Printrbot/Adaptrboard/Simple Metal/readme.md

## Printrbot Simple Metal

Download Repo as zip for your board, This firmware is for BigTreeeTech SKR Mini e3 v1.2 

Copy the firmware.bin file to micro SD Card, insert into printer and power on. Wait 10 seconds, the red status light on the board will stop blinking when complete.
