Printrbot/Adaptrboard/Big Tree Tech TFT LCD Custom Firmware/readme.md

Customized TFT LCD firmware for Printrbot Copy these these files to root directory of SD card
