Printrbot/Adaptrboard/Play/readme.md

##Printrbot Play

Download Repo as zip for your board, Check the model of your board (v1.2 most common) copy the firmware.bin file to micro SD Card, insert into printer and power on. Wait 10 seconds, the red status light on the board will stop blinking when complete.

SKR Mini E3 V1.2
SKR Mini E3 V1.0
