Printrbot/Adaptrboard/Adaptrboard STL Files/Metal Plus/LRS-350 PSU/LRS-350 Case.JPG

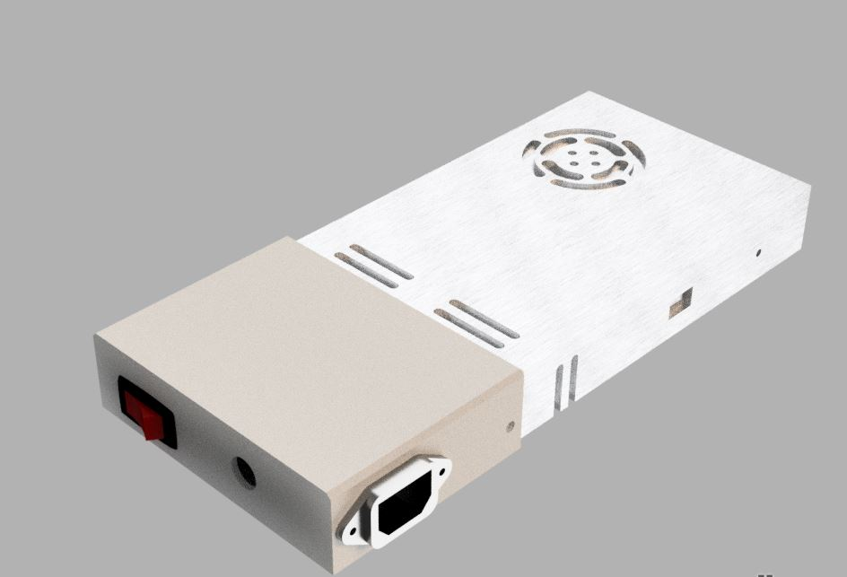
Adaptrboard STL Files/Metal Plus/LRS-350 PSU/LRS-350 Case.JPG
