Printrbot/Adaptrboard/Adaptrboard STL Files/Metal Plus/Metal Plus Adaptrboard.png

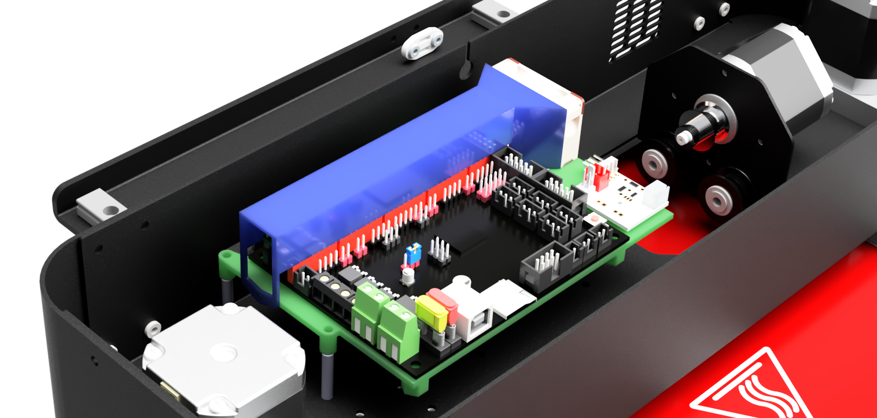
Adaptrboard STL Files/Metal Plus/Metal Plus Adaptrboard.png
