Printrbot/Adaptrboard/Adaptrboard STL Files/Simple Metal/Photos/board mount top.png

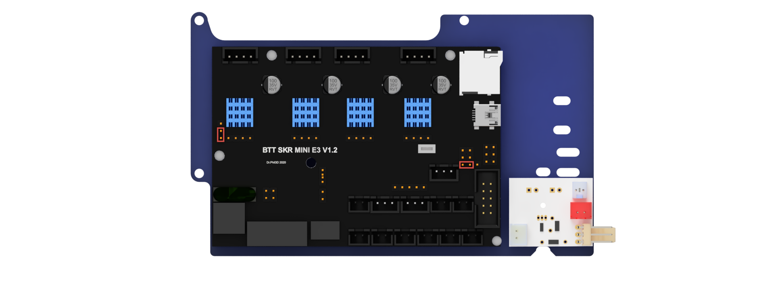
Adaptrboard STL Files/Simple Metal/Photos/board mount top.png
