Printrbot/Adaptrboard/Adaptrboard STL Files/Simple Metal/Photos/board mount.png

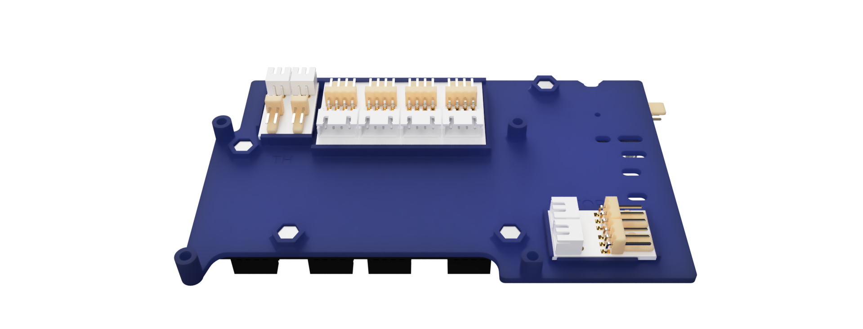
Adaptrboard STL Files/Simple Metal/Photos/board mount.png
