Printrbot/Adaptrboard/Adaptrboard STL Files/Simple Metal/Photos/simple metal upgraded.png

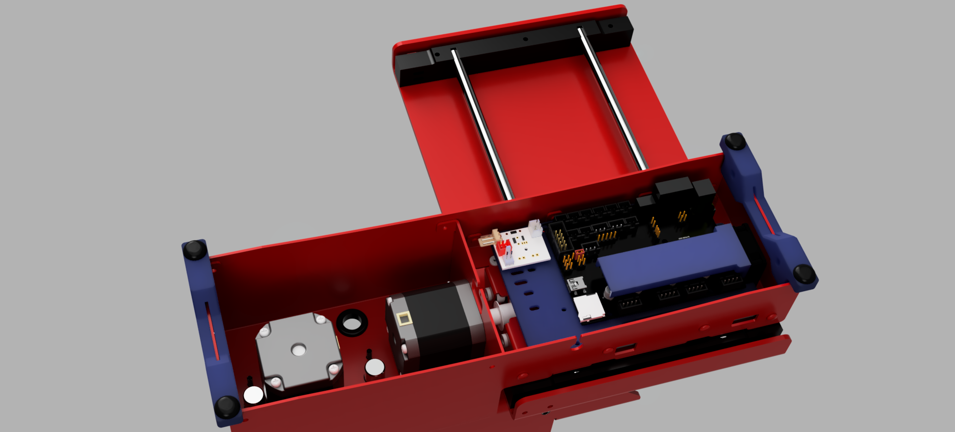
Adaptrboard STL Files/Simple Metal/Photos/simple metal upgraded.png
