Printrbot/Adaptrboard/Adaptrboard STL Files/Individual Cases/Thermistor Case.stl

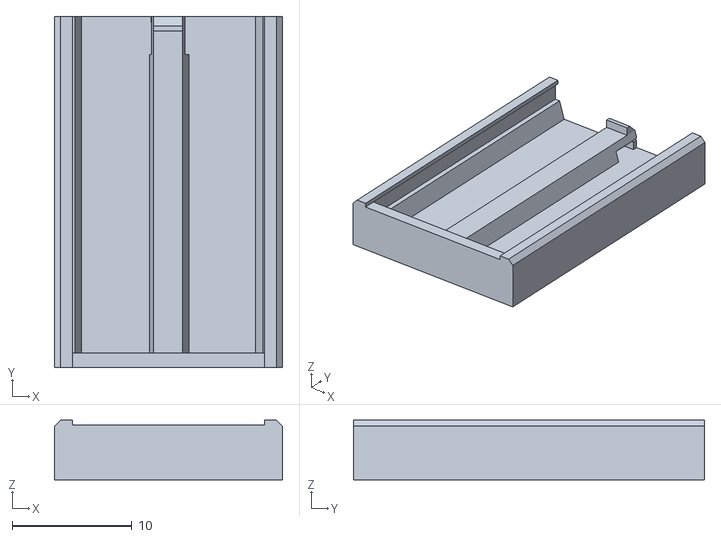
[picture p8: CAD file, 2020-04-28]
Adaptrboard STL Files/Individual Cases/Thermistor Case.stl
19.0 x 29.3 x 5.00
