Printrbot/Adaptrboard/Adaptrboard STL Files/Metal Plus/Metal Plus Adaptrboard_Stepper Fan Duct 40mmv1.stl

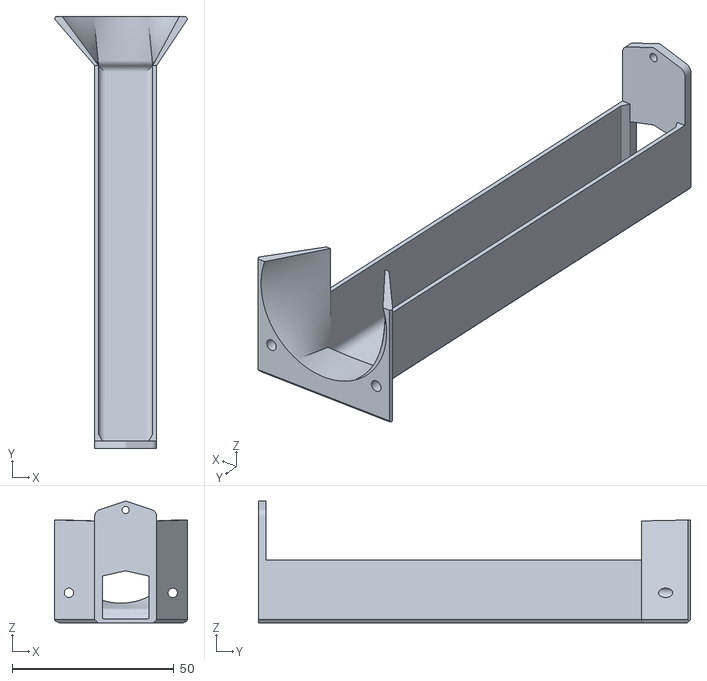
[picture p10: CAD file, 2020-05-24]
Adaptrboard STL Files/Metal Plus/Metal Plus Adaptrboard_Stepper Fan Duct 40mmv1.stl
41.2 x 133.7 x 37.7
