Printrbot/Adaptrboard/Printable Replacement Parts/Alu Extruder V2/Alu V2 Body.stl

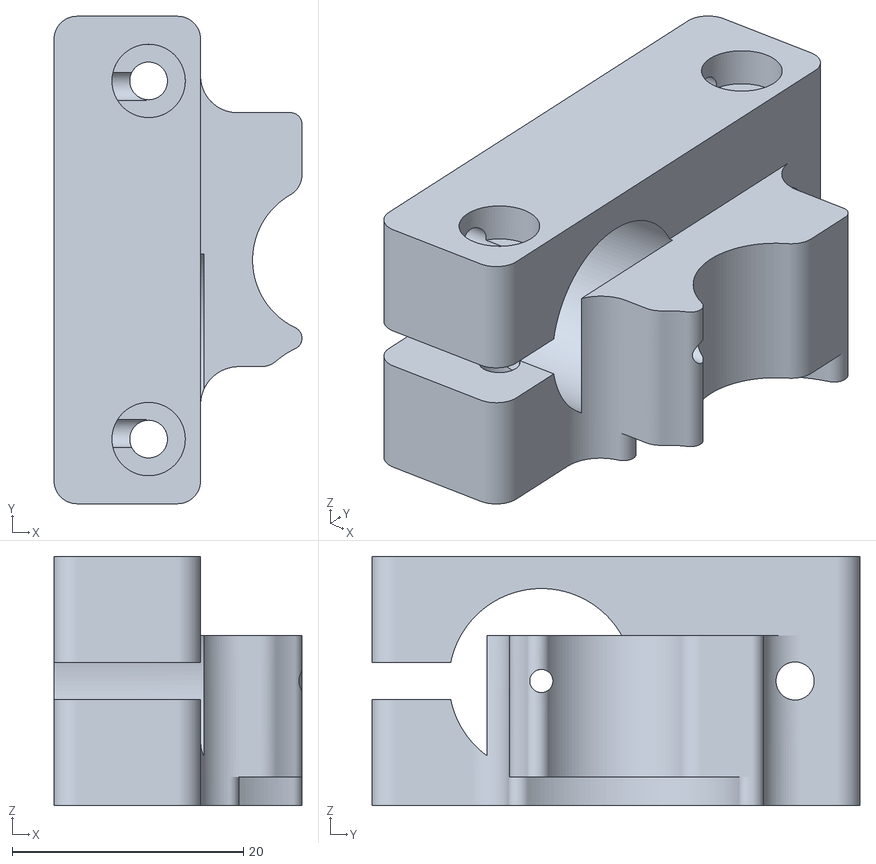
[picture p11: CAD file, 2020-05-17]
Printable Replacement Parts/Alu Extruder V2/Alu V2 Body.stl
21.5 x 42.2 x 21.6
