Printrbot/Adaptrboard/Printable Replacement Parts/Metal Plus/50 Fan Mount.stl

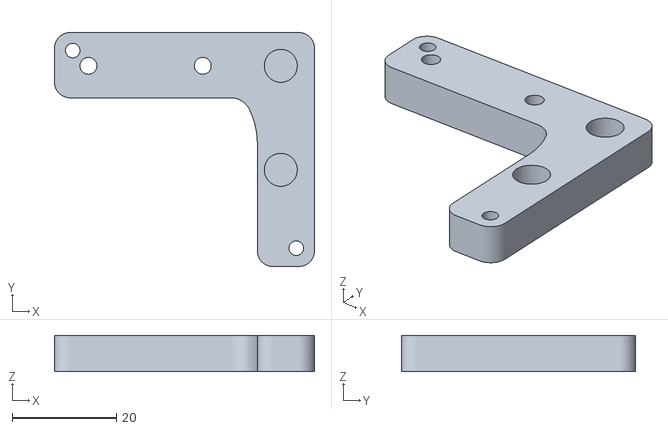
[picture p12: CAD file, 2020-05-12]
Printable Replacement Parts/Metal Plus/50 Fan Mount.stl
50.0 x 45.0 x 6.97
