Printrbot/Adaptrboard/Printable Replacement Parts/Metal Plus/Single Extruder Blower Fan/Plus_Blower_Fan_Mount_v2.stl

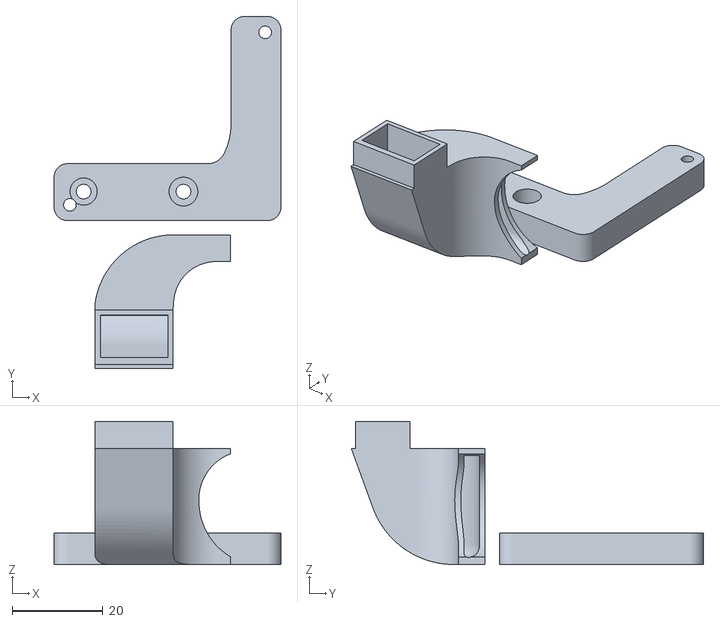
[picture p13: CAD file, 2020-05-24]
Printable Replacement Parts/Metal Plus/Single Extruder Blower Fan/Plus_Blower_Fan_Mount_v2.stl
50.0 x 77.6 x 31.5
