Printrbot/Adaptrboard/Printable Replacement Parts/Play V2 - Simple Pro/Playv2-SimplePro-Fan Shroud v4.stl

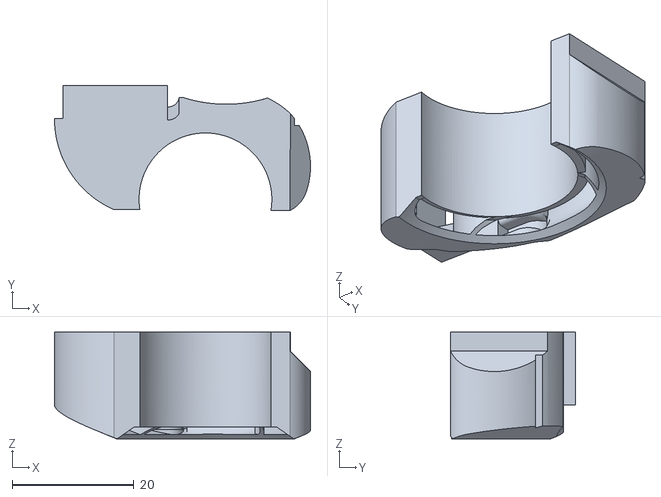
[picture p14: CAD file, 2020-05-17]
Printable Replacement Parts/Play V2 - Simple Pro/Playv2-SimplePro-Fan Shroud v4.stl
42.1 x 20.5 x 17.6
