Printrbot/Adaptrboard/Printable Replacement Parts/Play/4-Start Threaded Rod Upgrade/X-Z Spacer.stl

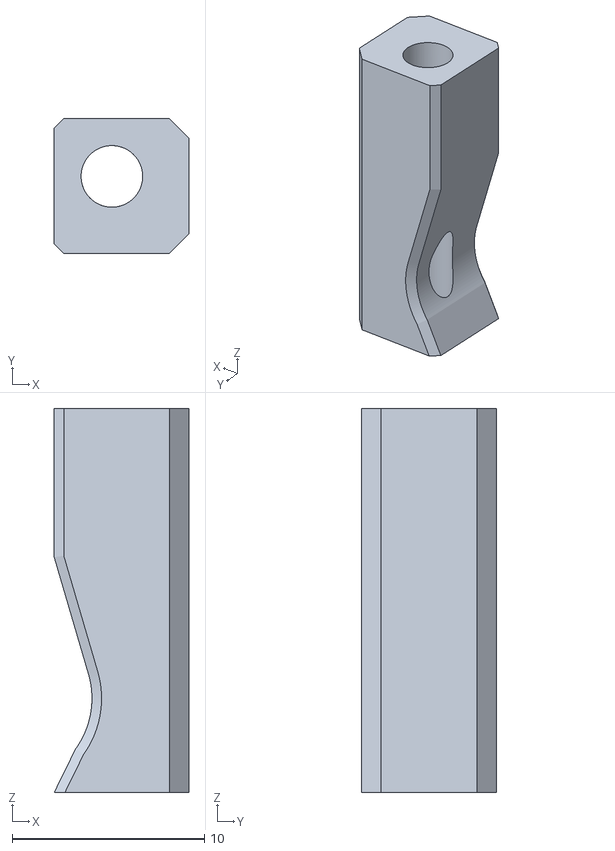
[picture p15: CAD file, 2020-05-12]
Printable Replacement Parts/Play/4-Start Threaded Rod Upgrade/X-Z Spacer.stl
7.00 x 7.00 x 20.0
