Printrbot/Adaptrboard/Printable Replacement Parts/Play/SKR-TFT LCD 2.4 Mount/TFT2.4 LCD.stl

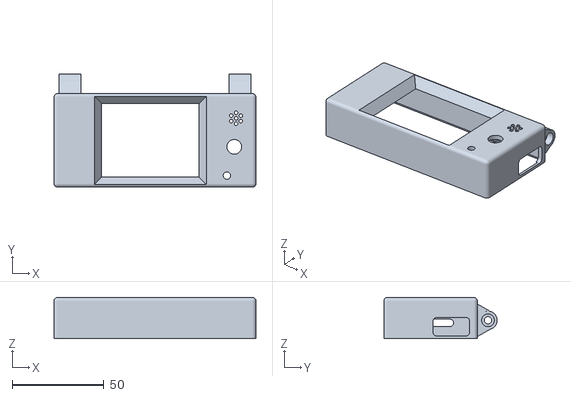
[picture p16: CAD file, 2020-05-12]
Printable Replacement Parts/Play/SKR-TFT LCD 2.4 Mount/TFT2.4 LCD.stl
110.0 x 61.8 x 22.5
