Printrbot/Adaptrboard/Printable Replacement Parts/Playv2-SimplePro-Fan Shroud v4 v3.stl

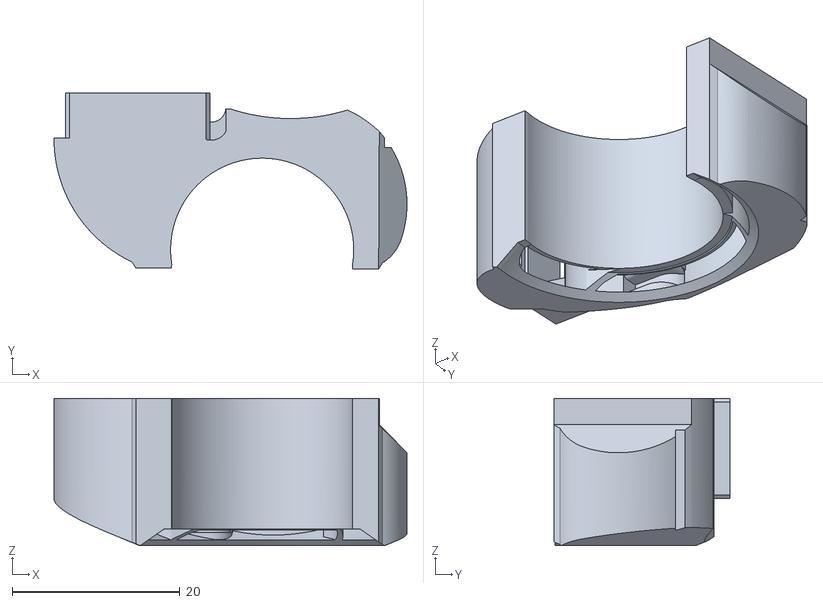
[picture p17: CAD file, 2020-05-24]
Printable Replacement Parts/Playv2-SimplePro-Fan Shroud v4 v3.stl
42.1 x 21.0 x 17.6
