Printrbot/Adaptrboard/Slicer Settings/Build Plate STL/Adoptabot X Axis Bed.stl

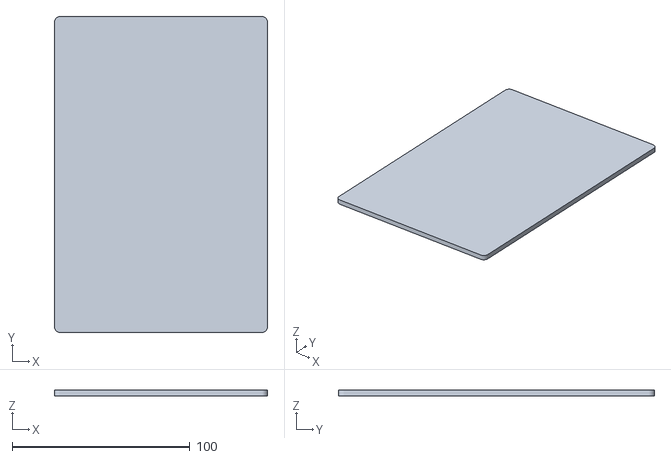
[picture p18: CAD file, 2020-04-26]
Slicer Settings/Build Plate STL/Adoptabot X Axis Bed.stl
120.0 x 178.0 x 3.18
