Printrbot/Adaptrboard/Adaptrboard STL Files/Individual Cases/Adaptrboard Case.stl

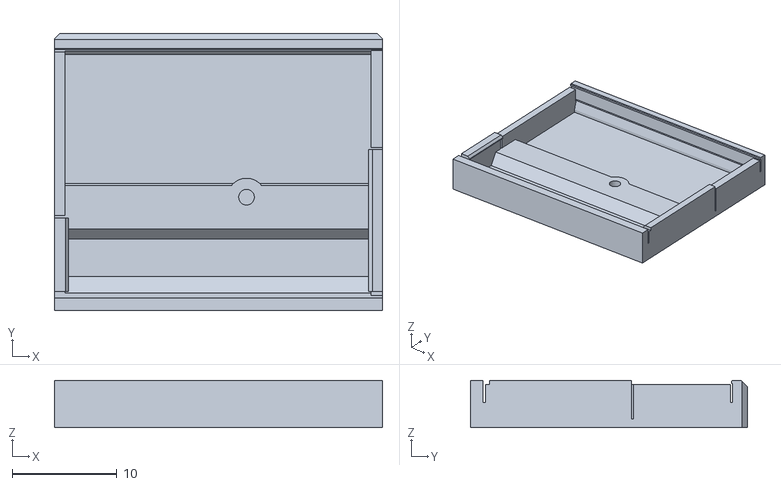
[picture p19: CAD file, 2020-04-28]
Adaptrboard STL Files/Individual Cases/Adaptrboard Case.stl
31.4 x 26.5 x 4.52
