Printrbot/Adaptrboard/Adaptrboard STL Files/Metal Plus/LRS-350 PSU/LRS-350-12 Case.stl

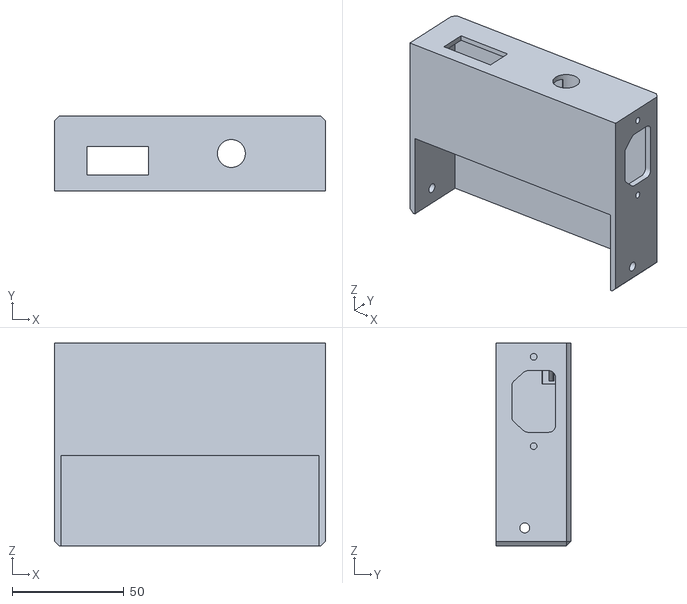
[picture p20: CAD file, 2020-05-25]
Adaptrboard STL Files/Metal Plus/LRS-350 PSU/LRS-350-12 Case.stl
121.4 x 33.4 x 90.8
