Printrbot/Adaptrboard/Adaptrboard STL Files/Metal Plus/Metal Plus Foot L.stl

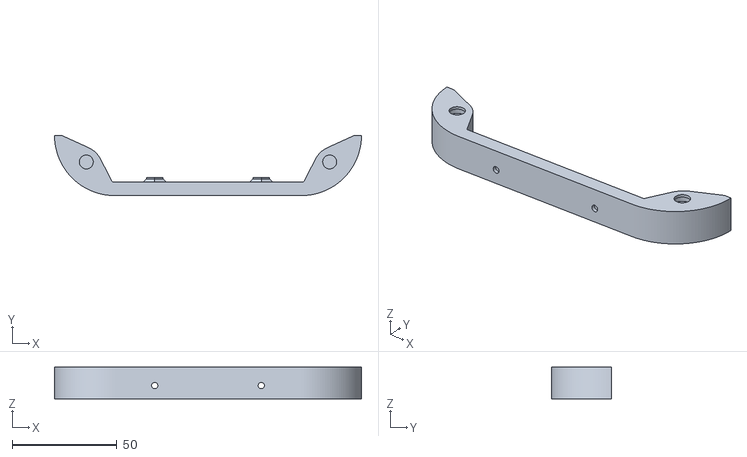
[picture p21: CAD file, 2020-05-24]
Adaptrboard STL Files/Metal Plus/Metal Plus Foot L.stl
146.3 x 28.7 x 15.2
