Printrbot/Adaptrboard/Printable Replacement Parts/Alu Extruder V2/Arm Post.stl

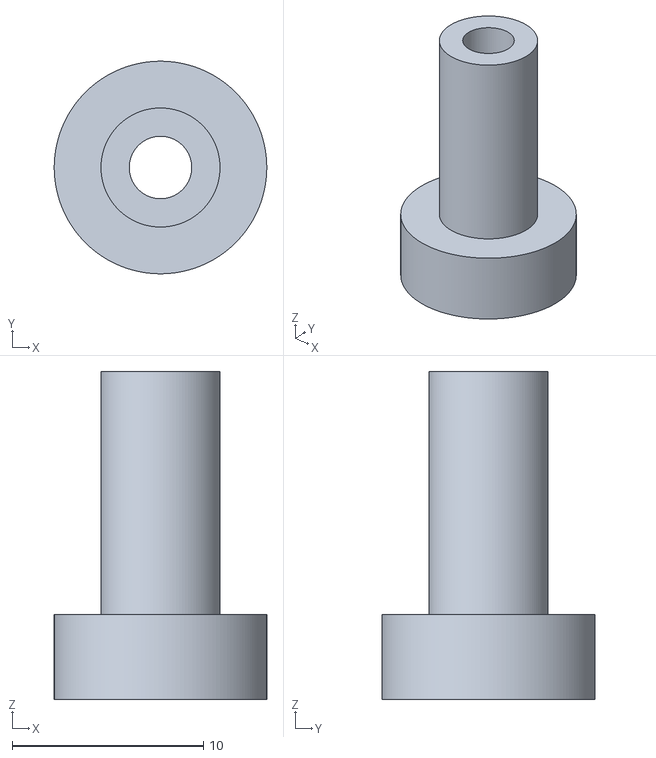
[picture p22: CAD file, 2020-05-17]
Printable Replacement Parts/Alu Extruder V2/Arm Post.stl
11.1 x 11.1 x 17.1
