Printrbot/Adaptrboard/Printable Replacement Parts/Metal Plus/Dual Extrusion Model/MP Sensor Mount v1.stl

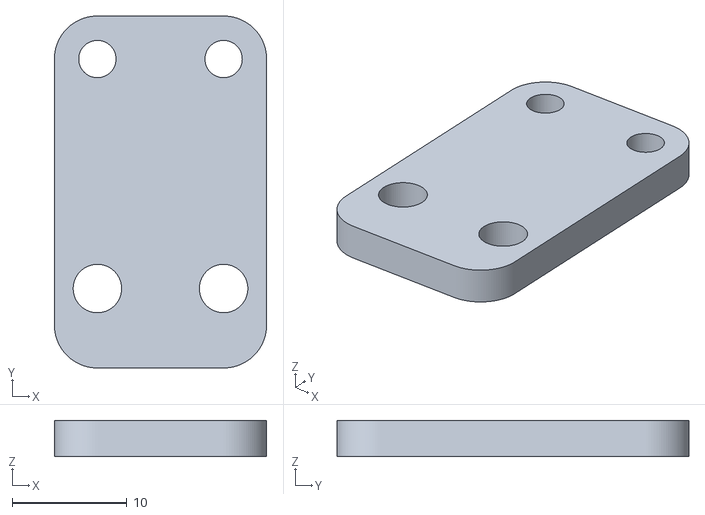
[picture p23: CAD file, 2020-05-12]
Printable Replacement Parts/Metal Plus/Dual Extrusion Model/MP Sensor Mount v1.stl
18.5 x 30.7 x 3.17
