Printrbot/Adaptrboard/Printable Replacement Parts/Metal Plus/Fan Mount.stl

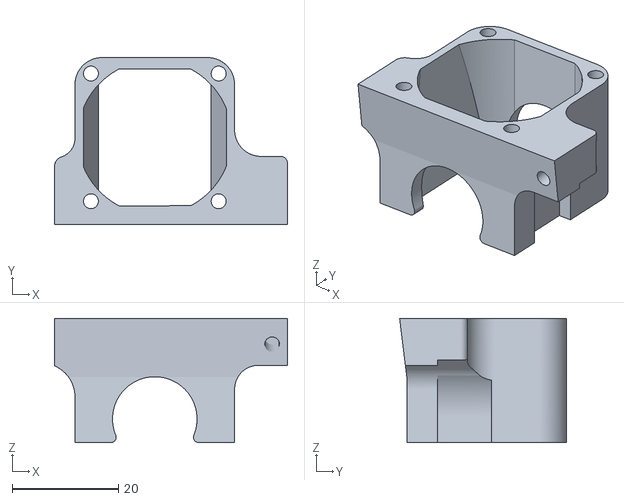
[picture p24: CAD file, 2020-05-12]
Printable Replacement Parts/Metal Plus/Fan Mount.stl
43.8 x 31.3 x 23.4
