Printrbot/Adaptrboard/Printable Replacement Parts/Play/Inductive Probe Clamp.stl

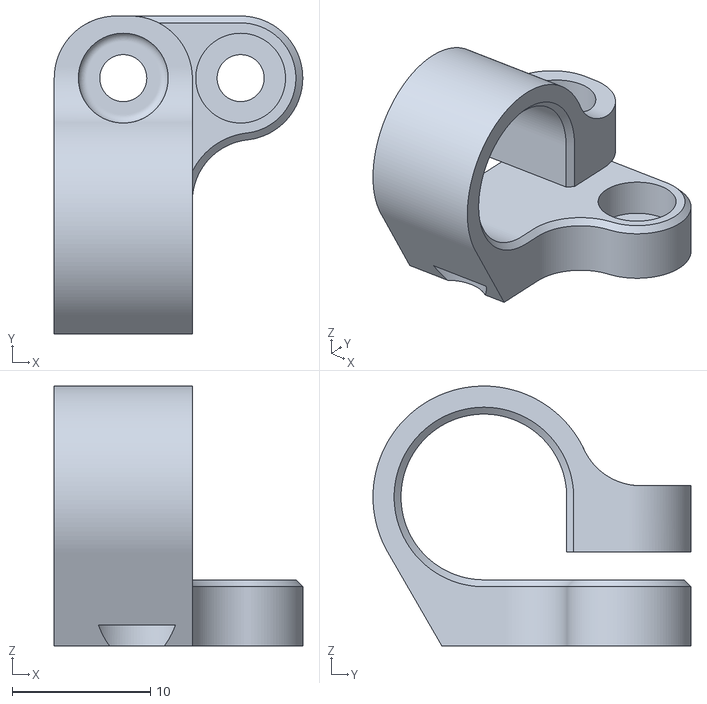
[picture p25: CAD file, 2020-05-12]
Printable Replacement Parts/Play/Inductive Probe Clamp.stl
18.0 x 23.0 x 18.8
