Printrbot/Adaptrboard/Printable Replacement Parts/Play/SKR-TFT LCD 2.4 Mount/TFT2.4 LCD Mount.stl

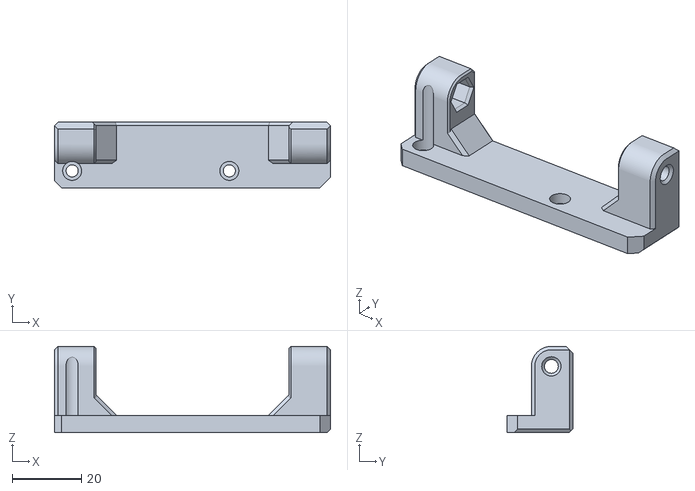
[picture p26: CAD file, 2020-05-12]
Printable Replacement Parts/Play/SKR-TFT LCD 2.4 Mount/TFT2.4 LCD Mount.stl
80.0 x 19.0 x 25.0
