Printrbot/Adaptrboard/Printable Replacement Parts/Printable Idler Pulley.stl

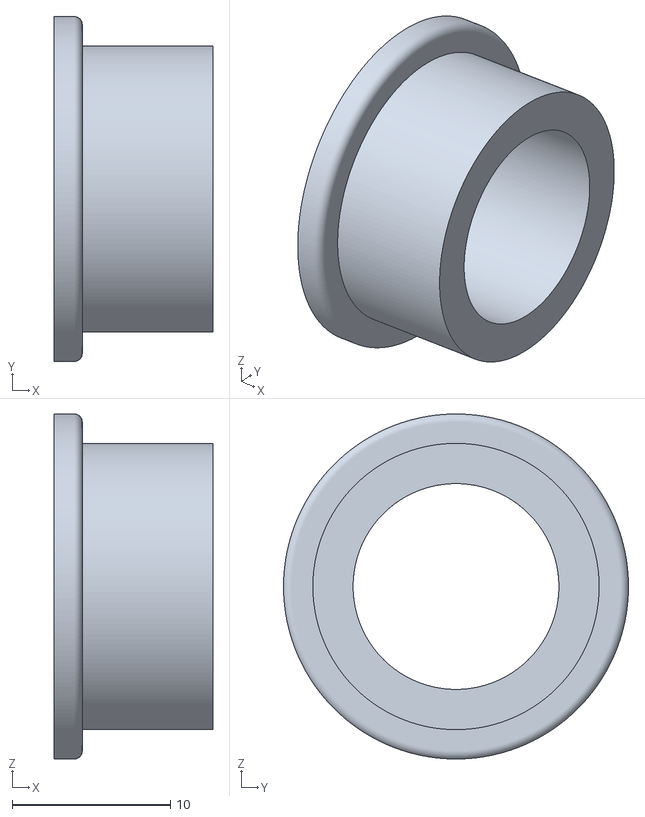
[picture p27: CAD file, 2020-05-12]
Printable Replacement Parts/Printable Idler Pulley.stl
10.0 x 21.8 x 21.8
