Printrbot/Adaptrboard/Slicer Settings/Build Plate STL/Simple Metal 10x8in bed.stl

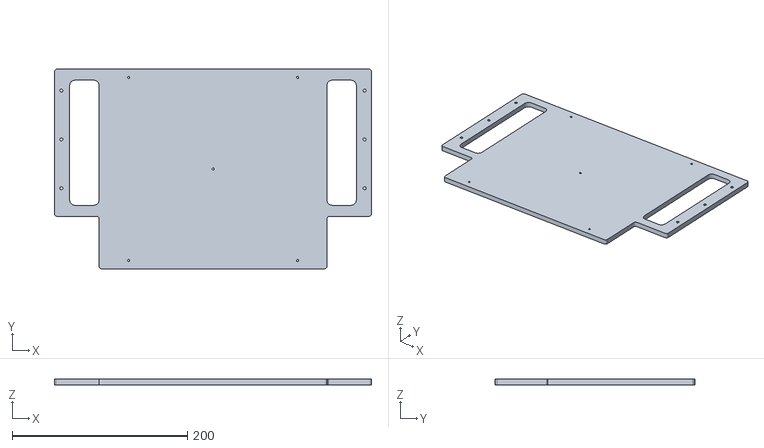
[picture p28: CAD file, 2020-04-26]
Slicer Settings/Build Plate STL/Simple Metal 10x8in bed.stl
362.1 x 228.3 x 6.35
