Printrbot/Adaptrboard/Adaptrboard STL Files/Individual Cases/Motor Breakout Case.stl

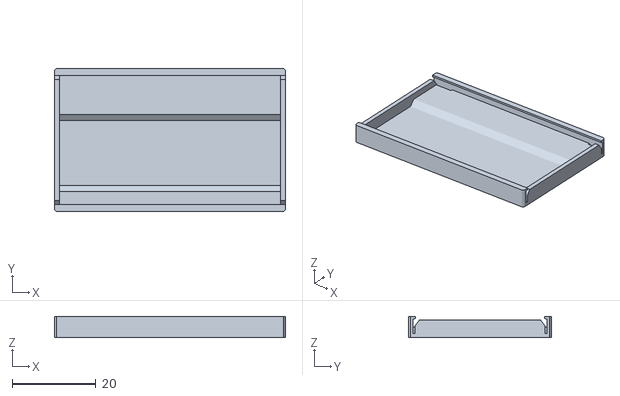
[picture p29: CAD file, 2020-04-28]
Adaptrboard STL Files/Individual Cases/Motor Breakout Case.stl
55.3 x 34.3 x 5.03
