Printrbot/Adaptrboard/Adaptrboard STL Files/Metal Plus/Metal Plus Foot R.stl

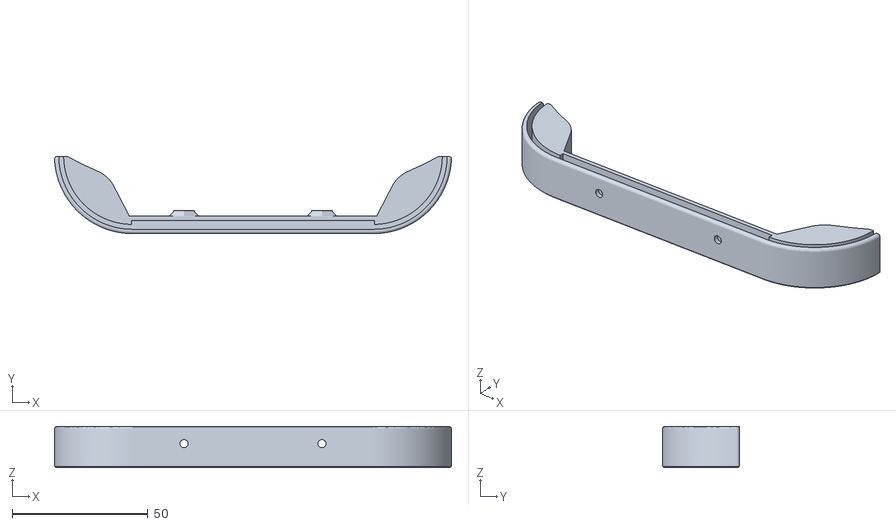
[picture p30: CAD file, 2020-05-24]
Adaptrboard STL Files/Metal Plus/Metal Plus Foot R.stl
146.2 x 28.5 x 15.2
