Printrbot/Adaptrboard/Adaptrboard STL Files/Simple Metal/Simple Metal - Front and Rear Feet.stl

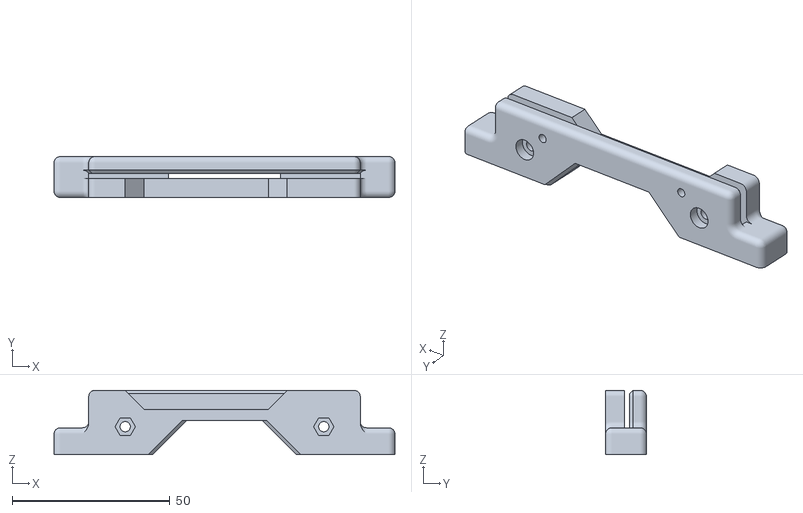
[picture p31: CAD file, 2020-05-11]
Adaptrboard STL Files/Simple Metal/Simple Metal - Front and Rear Feet.stl
108.1 x 13.0 x 20.4
