Printrbot/Adaptrboard/Printable Replacement Parts/Alu Extruder V2/Alu V2 Arm.stl

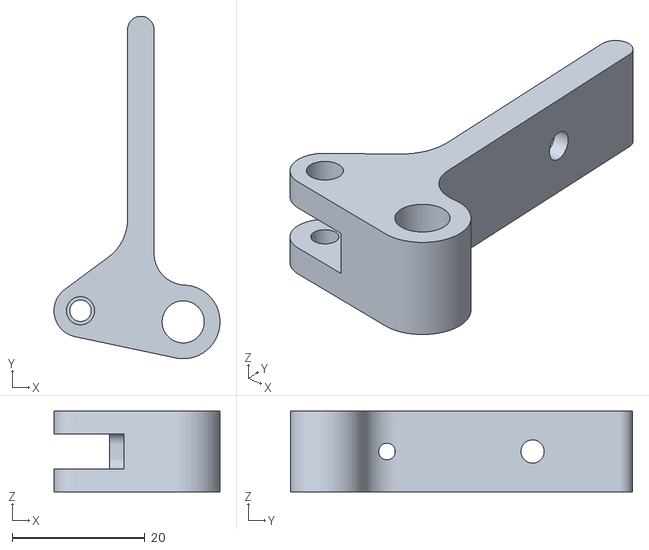
[picture p32: CAD file, 2020-05-17]
Printable Replacement Parts/Alu Extruder V2/Alu V2 Arm.stl
25.1 x 51.7 x 12.2
