Printrbot/Adaptrboard/Printable Replacement Parts/Metal Plus/Dual Extrusion Model/Fan Blower v2 Left.stl

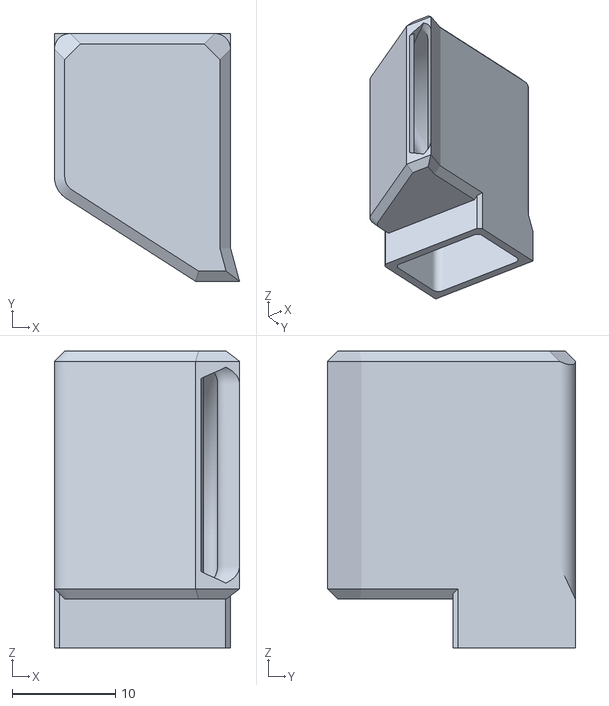
[picture p33: CAD file, 2020-05-12]
Printable Replacement Parts/Metal Plus/Dual Extrusion Model/Fan Blower v2 Left.stl
18.0 x 24.1 x 28.8
