Printrbot/Adaptrboard/Printable Replacement Parts/Metal Plus/Single Extruder Blower Fan/Plus Blower Fan Shroud.3mf

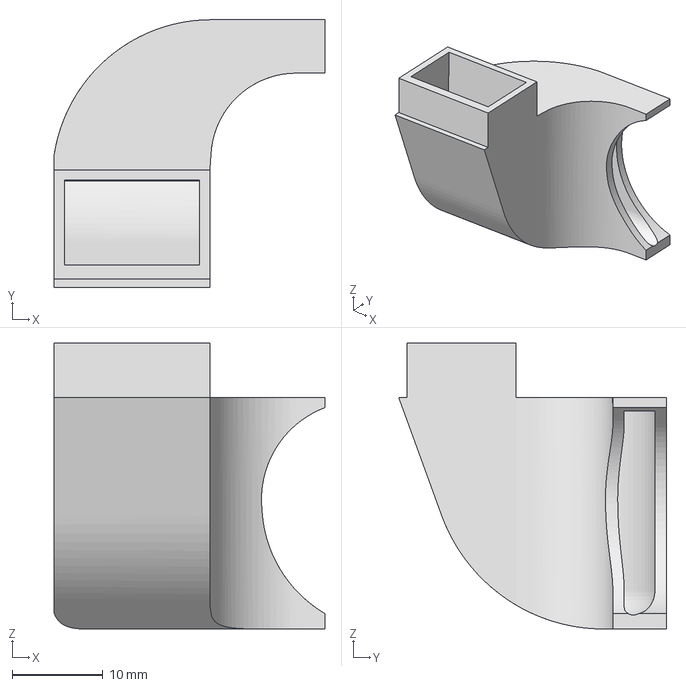
[picture p34: CAD file, 2020-05-24]
Printable Replacement Parts/Metal Plus/Single Extruder Blower Fan/Plus Blower Fan Shroud.3mf
29.8 x 29.5 x 31.5 mm
