Printrbot/Adaptrboard/Printable Replacement Parts/Play/Y-Bearing Holder Single.stl

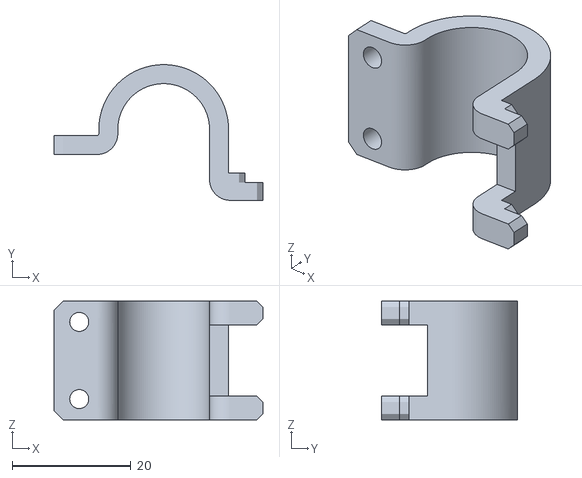
[picture p35: CAD file, 2020-05-12]
Printable Replacement Parts/Play/Y-Bearing Holder Single.stl
35.2 x 22.9 x 20.0
