Printrbot/Adaptrboard/Slicer Settings/Build Plate STL/Play Heated Bed Model 100mmx205mm.stl

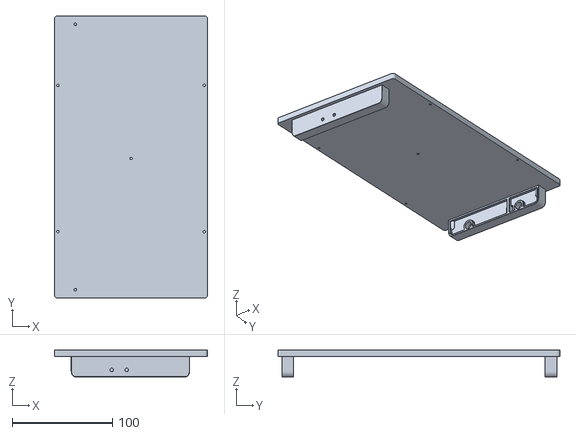
[picture p36: CAD file, 2020-04-26]
Slicer Settings/Build Plate STL/Play Heated Bed Model 100mmx205mm.stl
152.9 x 281.4 x 26.7
