Printrbot/Adaptrboard/Adaptrboard STL Files/Simple Metal/Simple Metal - Adaptrboard - Controler Fan Duct.stl

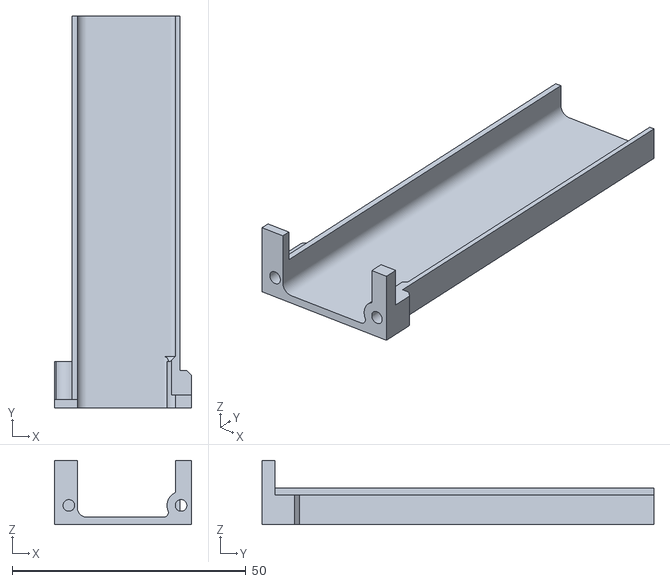
[picture p37: CAD file, 2020-05-11]
Adaptrboard STL Files/Simple Metal/Simple Metal - Adaptrboard - Controler Fan Duct.stl
29.3 x 83.9 x 13.7
