Printrbot/Adaptrboard/Printable Replacement Parts/Play/PB Mini Y Bar End Tensioner Side.stl

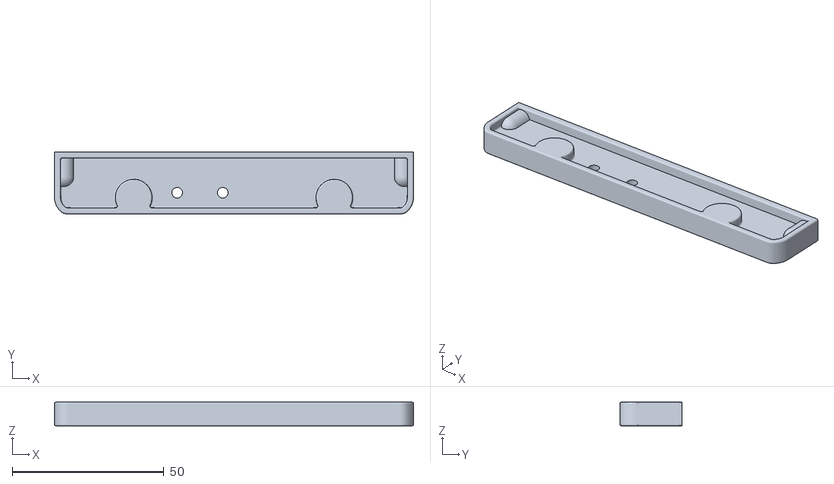
[picture p38: CAD file, 2020-05-12]
Printable Replacement Parts/Play/PB Mini Y Bar End Tensioner Side.stl
118.1 x 20.4 x 7.87
