Printrbot/Adaptrboard/Slicer Settings/Build Plate STL/Simple Pro Print Bed.stl

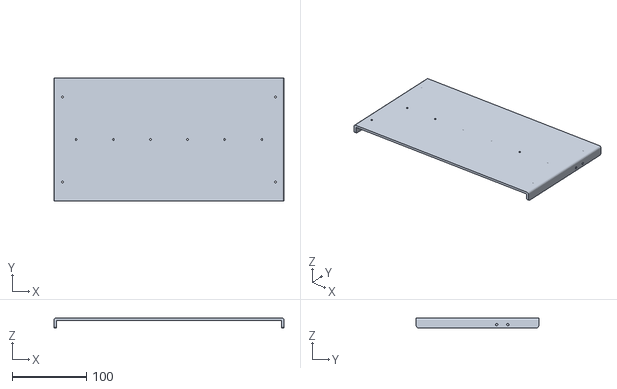
[picture p39: CAD file, 2020-04-26]
Slicer Settings/Build Plate STL/Simple Pro Print Bed.stl
309.8 x 165.1 x 13.5
