Printrbot/Adaptrboard/Adaptrboard STL Files/Metal Plus/Spacer.stl

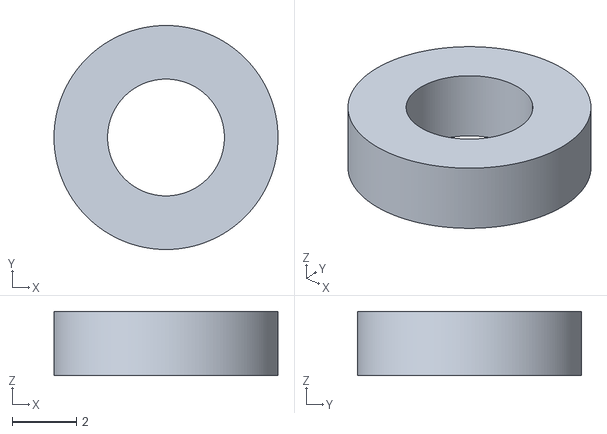
[picture p40: CAD file, 2020-05-11]
Adaptrboard STL Files/Metal Plus/Spacer.stl
7.00 x 7.00 x 2.00
