Printrbot/Adaptrboard/Printable Replacement Parts/Metal Plus/Dual Extrusion Model/Single Fan Dual Hotend.stl

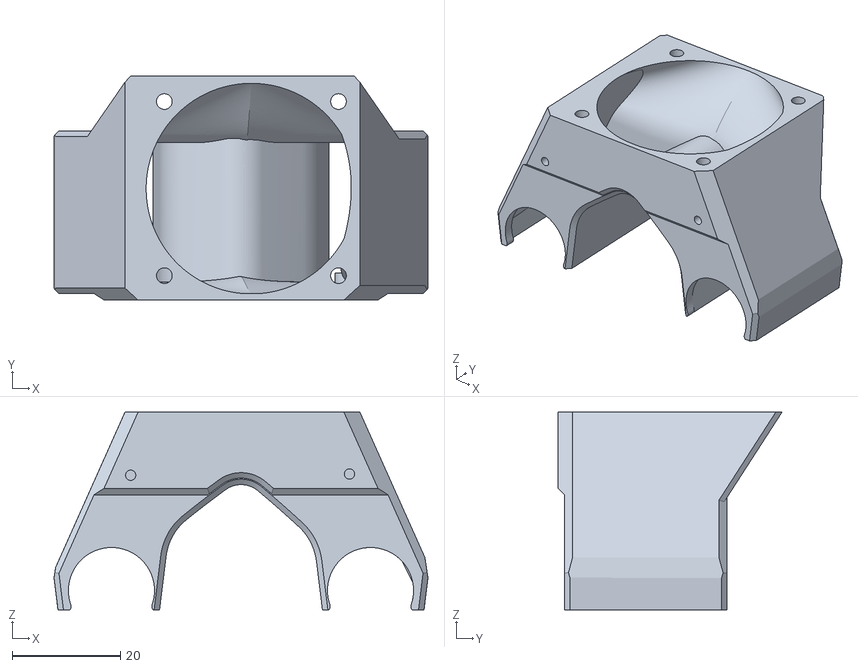
[picture p41: CAD file, 2020-05-12]
Printable Replacement Parts/Metal Plus/Dual Extrusion Model/Single Fan Dual Hotend.stl
69.0 x 41.3 x 36.5
