Printrbot/Adaptrboard/Printable Replacement Parts/Play/50mm Fan Mount.stl

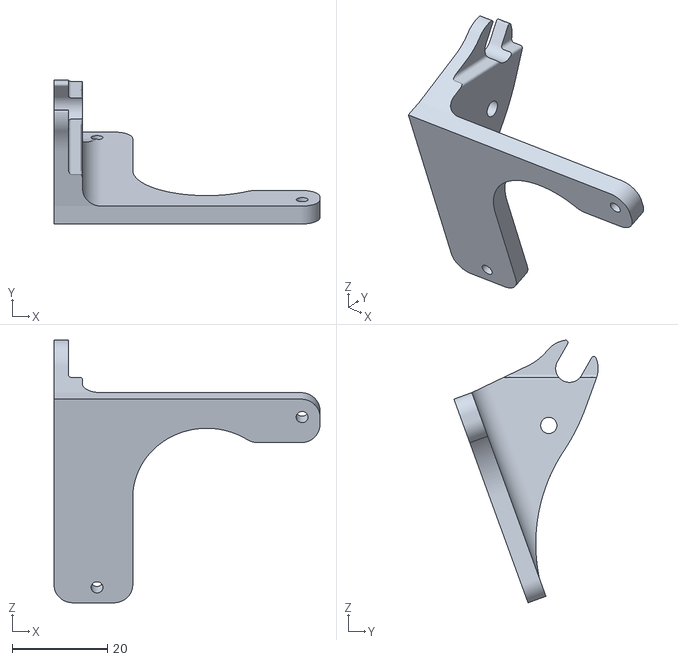
[picture p42: CAD file, 2020-05-12]
Printable Replacement Parts/Play/50mm Fan Mount.stl
55.8 x 30.2 x 55.1
