Printrbot/Adaptrboard/Slicer Settings/Build Plate STL/Simple Metal 10in bed.stl

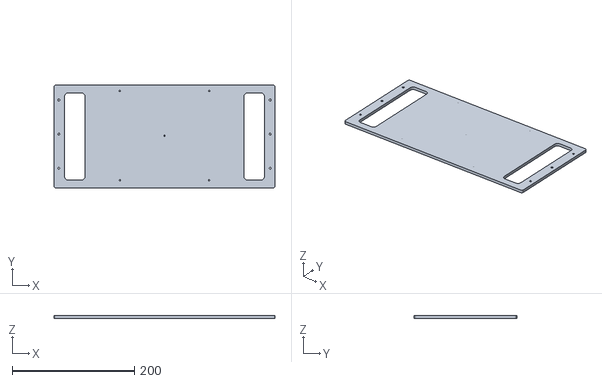
[picture p43: CAD file, 2020-04-26]
Slicer Settings/Build Plate STL/Simple Metal 10in bed.stl
362.1 x 168.3 x 4.76
