Printrbot/Adaptrboard/Adaptrboard STL Files/Metal Plus/Metal Plus Adaptrboard_Board Mount v1.stl

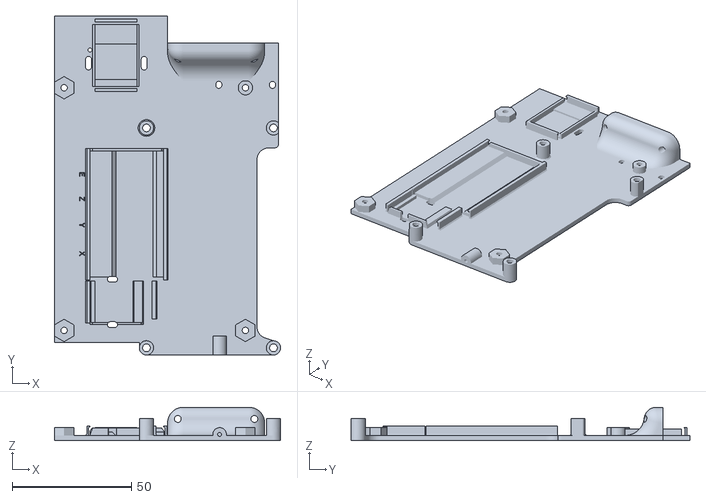
[picture p44: CAD file, 2020-05-11]
Adaptrboard STL Files/Metal Plus/Metal Plus Adaptrboard_Board Mount v1.stl
94.9 x 142.3 x 13.9
