Printrbot/Adaptrboard/Printable Replacement Parts/Play/Printrbot Play - Dual Bering Y Axis Clamp.stl

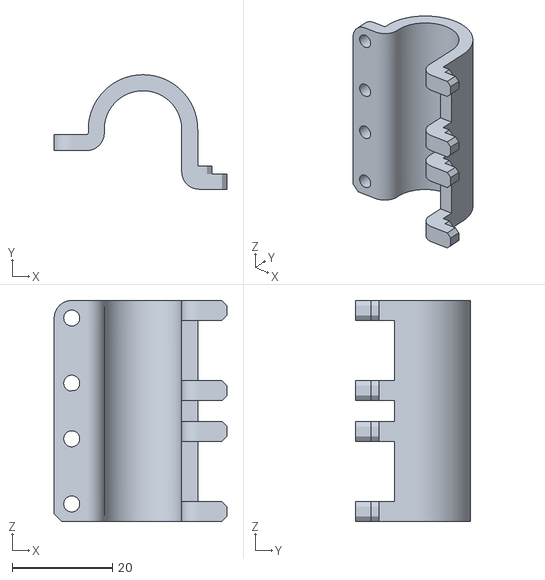
[picture p45: CAD file, 2020-05-12]
Printable Replacement Parts/Play/Printrbot Play - Dual Bering Y Axis Clamp.stl
34.4 x 22.9 x 44.1
