Printrbot/Adaptrboard/Slicer Settings/Build Plate STL/Simple Metal Stock Bed.stl

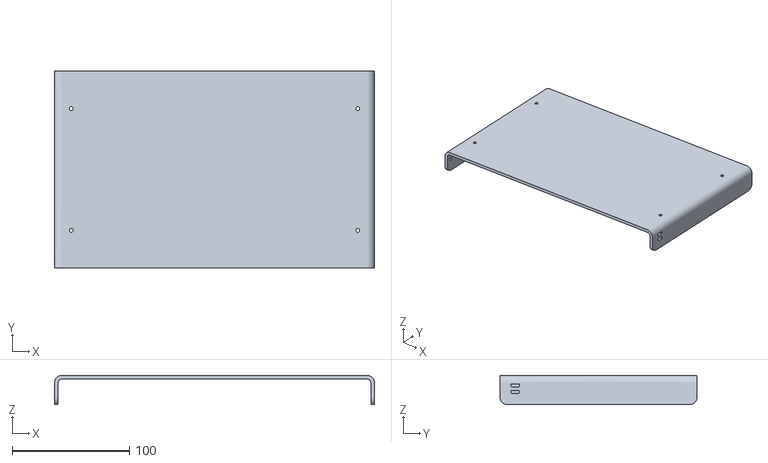
[picture p46: CAD file, 2020-04-26]
Slicer Settings/Build Plate STL/Simple Metal Stock Bed.stl
273.4 x 168.3 x 25.0
