Printrbot/Adaptrboard/Printable Replacement Parts/Play/Turbo Fan 50mm Fan Duct.stl

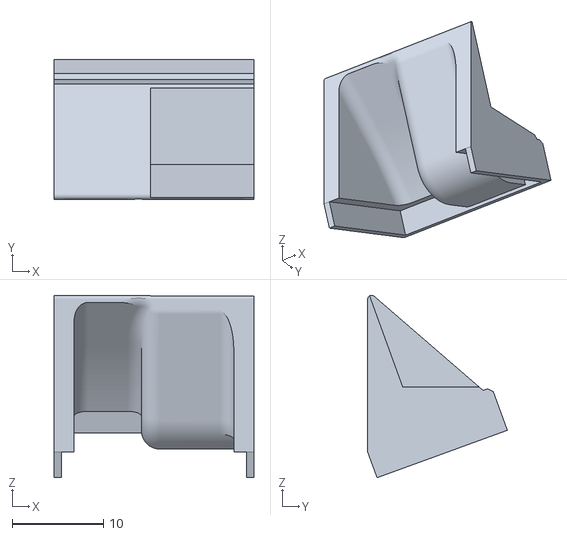
[picture p47: CAD file, 2020-05-12]
Printable Replacement Parts/Play/Turbo Fan 50mm Fan Duct.stl
21.9 x 15.3 x 19.9
