Printrbot/Adaptrboard/Slicer Settings/Build Plate STL/Printrbot Plus Bed - Alu Only.stl

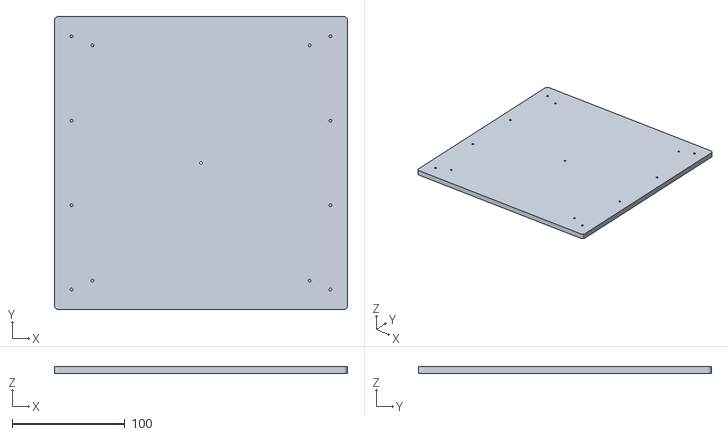
[picture p48: CAD file, 2020-04-26]
Slicer Settings/Build Plate STL/Printrbot Plus Bed - Alu Only.stl
260.4 x 260.4 x 6.35
