Printrbot/Adaptrboard/Printable Replacement Parts/Play/Delrin Cable tab from back of extruder.dxf

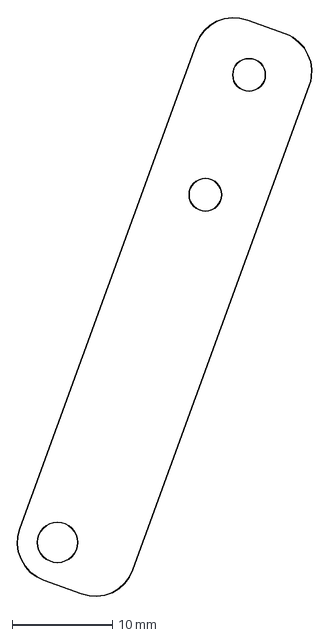
[picture p49: CAD file, 2020-05-12]
Printable Replacement Parts/Play/Delrin Cable tab from back of extruder.dxf
29.9 x 57.8 mm
