Printrbot/Adaptrboard/Slicer Settings/Build Plate STL/Printrbot Smalls Bed.stl

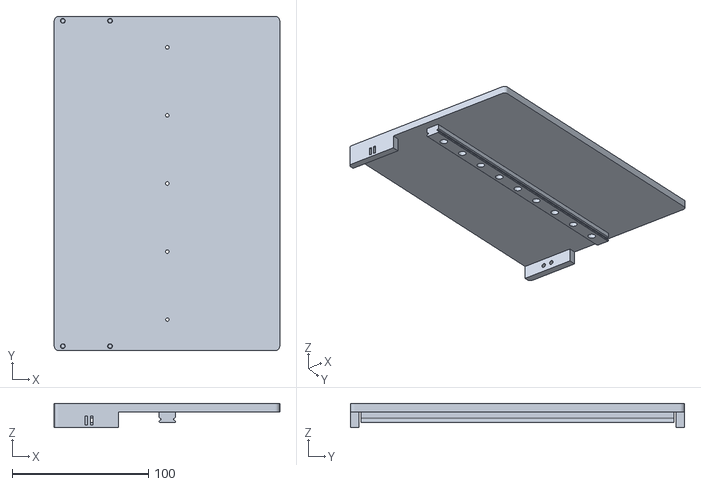
[picture p50: CAD file, 2020-04-26]
Slicer Settings/Build Plate STL/Printrbot Smalls Bed.stl
165.7 x 245.4 x 17.8
