Printrbot/Adaptrboard/(list of files, cad)

Other CAD files:
Printable Replacement Parts/Metal Plus/Dual Extrusion Model/Plus 50mm Blower Fan_Mount_v2.3mf
Printable Replacement Parts/Metal Plus/Single Extruder Blower Fan/Plus 50mm Blower Fan_Mount_v2.3mf
Adaptrboard STL Files/Metal Plus/Metal Plus Feet.stl
Printable Replacement Parts/Metal Plus/Dual Extrusion Model/Fan Blower v2 Right.stl
Adaptrboard STL Files/Metal Plus/Metal Plus Feet.f3d
Adaptrboard STL Files/Simple Metal/Simple Metal - Adaptrboard - Control Board Mont - M3 Nut.stl
Adaptrboard STL Files/Simple Metal/Simple Metal - Adaptrboard - Control Board Mont - Plastite Screws.stl
Printable Replacement Parts/Alu Extruder V2/Alu Extruder V2 v3.f3d
Printable Replacement Parts/Metal Plus/Single Extruder Blower Fan/Plus 50mm Blower Fan_Mount_v2.stl
Printable Replacement Parts/Play/4-Start Threaded Rod Upgrade/PB Playv1_PB Printed Mini Z Nut 4-start (untested).stl
Printable Replacement Parts/Play/4-Start Threaded Rod Upgrade/Play 4-Start Lead Screw Upgradde.stl
Printable Replacement Parts/Play/PB Play v1_PB Mini Z Nut v4.stl
