Printrbot/Adaptrboard/Adaptrboard STL Files/Simple Metal/Photos/Adaptrboard Wiring.png

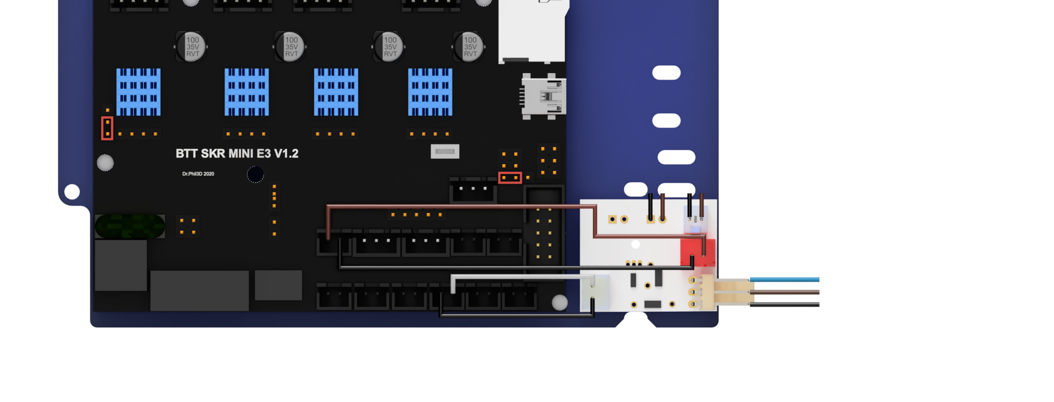
Adaptrboard STL Files/Simple Metal/Photos/Adaptrboard Wiring.png
