Printrbot/Adaptrboard/Schematic_Adaptrboard_2020-05-26_13-58-08.pdf

## Motor Breakout Board Endstop Breakout

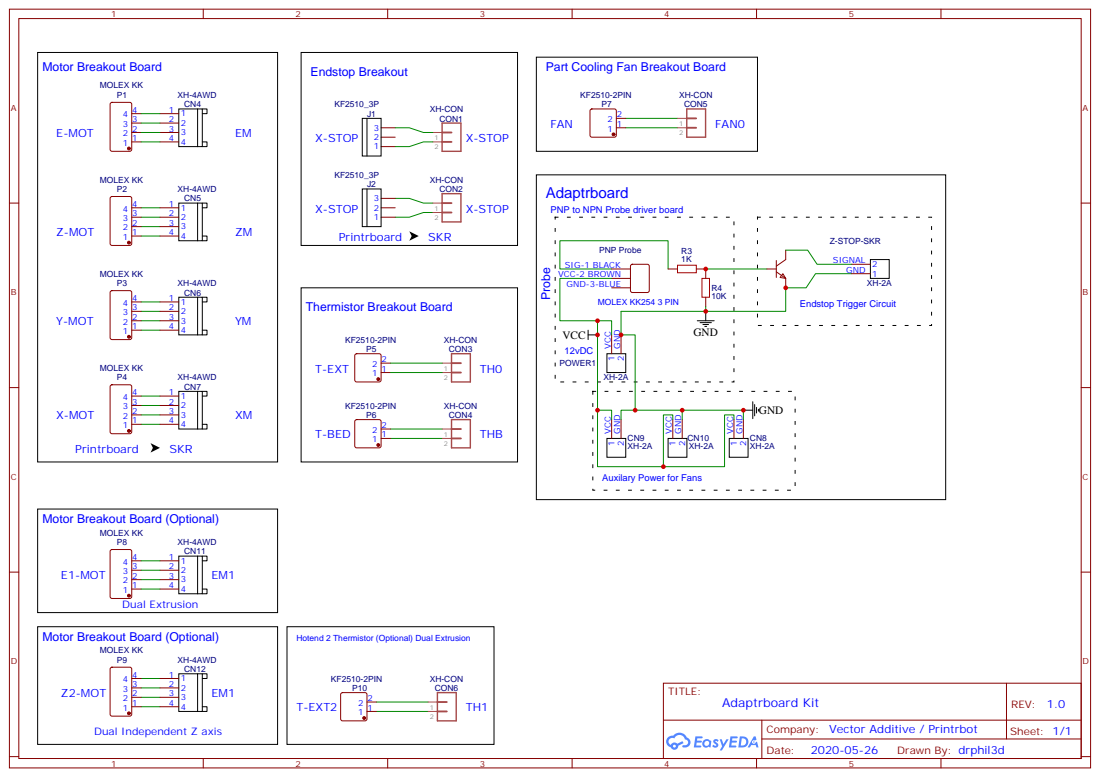
[picture p53: page 1]

Part Cooling Fan Breakout Board

Adaptrboard
PNP to NPN Probe driver board

Auxilary Power for Fans

Motor Breakout Board (Optional)

Hotend 2 Thermistor (Optional) Dual Extrusion

Company: Vector Additive / Printrbot

# Adaptrboard

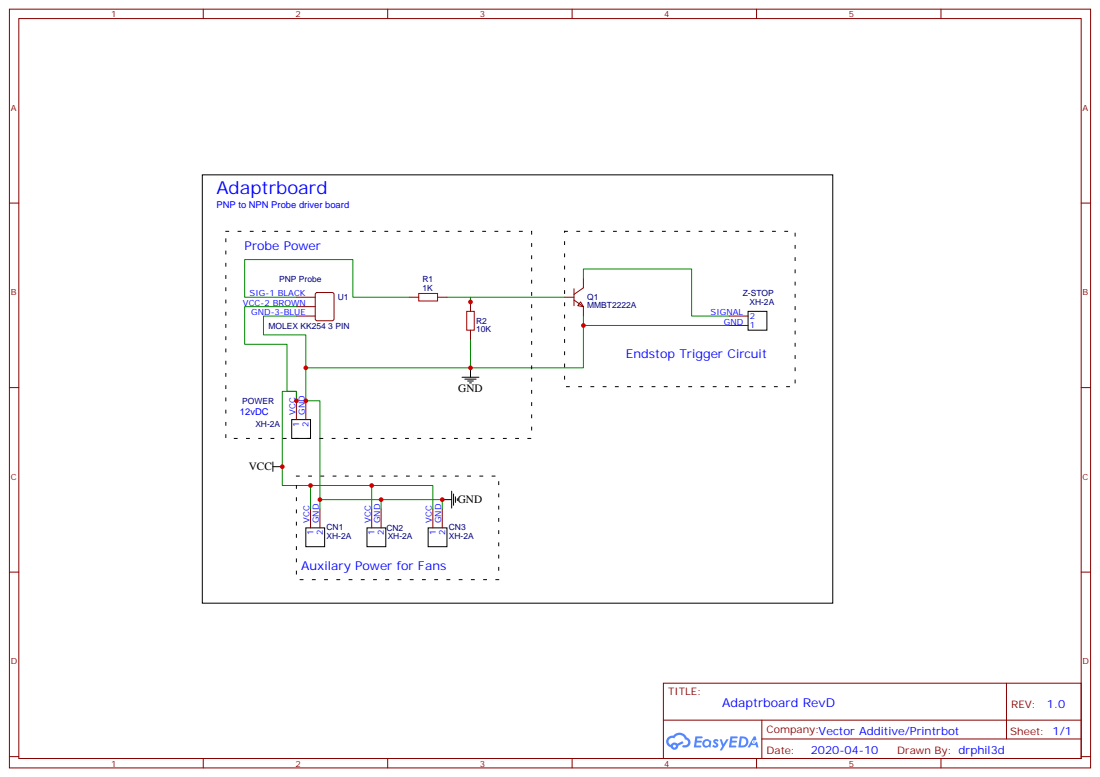
[picture p54: page 2]

PNP to NPN Probe driver board

Company:Vector Additive/Printrbot
