Printrbot/Adaptrboard/PCBs Drawing v3.pdf

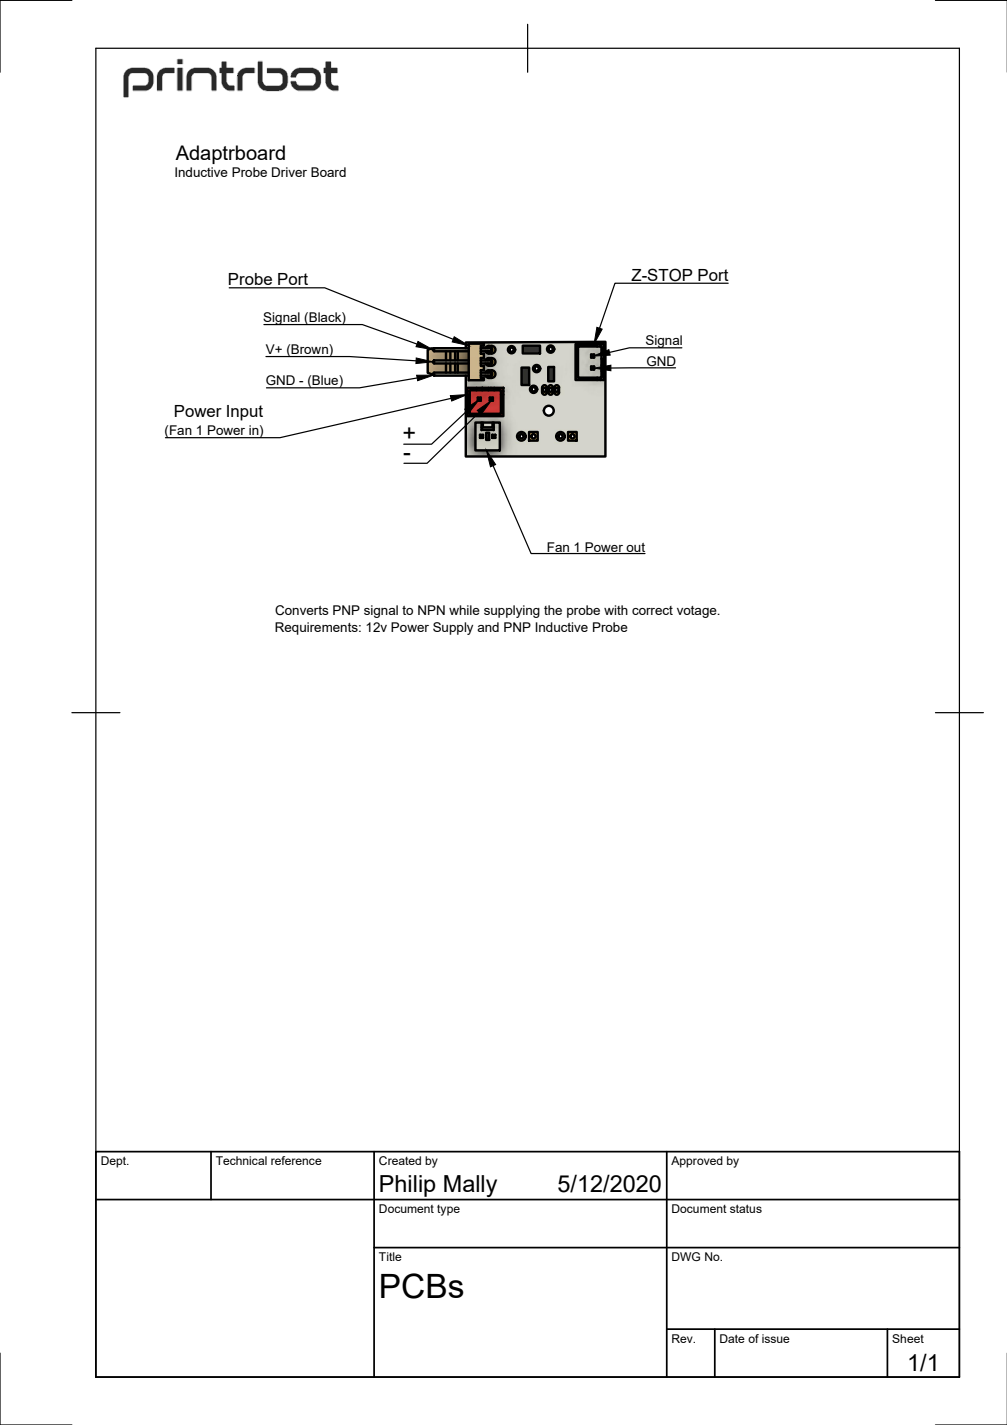
[picture p55: page 1]
Signal (Black); V+ (Brown); GND - (Blue); Probe Port; Z-STOP Port

Adaptrboard
Inductive Probe Driver Board

Power Input
(Fan 1 Power in)

Fan 1 Power out

Converts PNP signal to NPN while supplying the probe with correct votage.
Requirements: 12v Power Supply and PNP Inductive Probe

Dept. | Technical reference | Created by Philip Mally 5/12/2020 | Approved by

Document type | Document status

Title PCBs | DWG No.

Rev. | Date of issue | Sheet 1/1
