Printrbot/Adaptrboard/Play/SKR Mini e3 v1.2/Latest Build/Configuration.h

#pragma once
#define CONFIGURATION_H_VERSION 020005
#define STRING_CONFIG_H_AUTHOR "(Dr.Phil3D)"            // Who made the changes.
#define SHOW_BOOTSCREEN
#define SERIAL_PORT 2
#define SERIAL_PORT_2 -1
#define BAUDRATE 250000
  #define MOTHERBOARD BOARD_BTT_SKR_MINI_E3_V1_2
#define CUSTOM_MACHINE_NAME "Printrbot Play 32bit"
#define MACHINE_UUID "40ce61d1-2ed0-4530-8304-55e3eeaaebff"
#define EXTRUDERS 1
#define DEFAULT_NOMINAL_FILAMENT_DIA 1.75
#define TEMP_SENSOR_0 1
#define TEMP_SENSOR_1 0
#define TEMP_SENSOR_2 0
#define TEMP_SENSOR_3 0
#define TEMP_SENSOR_4 0
#define TEMP_SENSOR_5 0
#define TEMP_SENSOR_6 0
#define TEMP_SENSOR_7 0
#define TEMP_SENSOR_BED 0
#define TEMP_SENSOR_PROBE 0
#define TEMP_SENSOR_CHAMBER 0
#define DUMMY_THERMISTOR_998_VALUE 25
#define DUMMY_THERMISTOR_999_VALUE 100
#define MAX_REDUNDANT_TEMP_SENSOR_DIFF 10
#define TEMP_RESIDENCY_TIME     10  // (seconds) Time to wait for hotend to "settle" in M109
#define TEMP_WINDOW              1  // (°C) Temperature proximity for the "temperature reached" timer
#define TEMP_HYSTERESIS          3  // (°C) Temperature proximity considered "close enough" to the target
#define TEMP_BED_RESIDENCY_TIME 10  // (seconds) Time to wait for bed to "settle" in M190
#define TEMP_BED_WINDOW          1  // (°C) Temperature proximity for the "temperature reached" timer
#define TEMP_BED_HYSTERESIS      5  // (°C) Temperature proximity considered "close enough" to the target
#define HEATER_0_MINTEMP   3
#define HEATER_1_MINTEMP   5
#define HEATER_2_MINTEMP   5
#define HEATER_3_MINTEMP   5
#define HEATER_4_MINTEMP   5
#define HEATER_5_MINTEMP   5
#define HEATER_6_MINTEMP   5
#define HEATER_7_MINTEMP   5
#define BED_MINTEMP        3
#define HEATER_0_MAXTEMP 285
#define HEATER_1_MAXTEMP 275
#define HEATER_2_MAXTEMP 275
#define HEATER_3_MAXTEMP 275
#define HEATER_4_MAXTEMP 275
#define HEATER_5_MAXTEMP 275
#define HEATER_6_MAXTEMP 275
#define HEATER_7_MAXTEMP 275
#define BED_MAXTEMP      150
#define PIDTEMP
#define BANG_MAX 255     // Limits current to nozzle while in bang-bang mode; 255=full current
#define PID_MAX BANG_MAX // Limits current to nozzle while PID is active (see PID_FUNCTIONAL_RANGE below); 255=full current
#define PID_K1 0.95      // Smoothing factor within any PID loop
  #define PID_EDIT_MENU           // Add PID editing to the "Advanced Settings" menu. (~700 bytes of PROGMEM)
  #define PID_AUTOTUNE_MENU       // Add PID auto-tuning to the "Advanced Settings" menu. (~250 bytes of PROGMEM)
  #define PID_FUNCTIONAL_RANGE 10 // If the temperature difference between the target temperature and the actual temperature
  #define DEFAULT_Kp 40.15
  #define DEFAULT_Ki 7.10
  #define DEFAULT_Kd 56.73
#define PIDTEMPBED
#define MAX_BED_POWER 170 // limits duty cycle to bed; 255=full current
  #define DEFAULT_bedKp 30.56
  #define DEFAULT_bedKi 5.69
  #define DEFAULT_bedKd 109.42
#define PREVENT_COLD_EXTRUSION
#define EXTRUDE_MINTEMP 170
#define PREVENT_LENGTHY_EXTRUDE
#define EXTRUDE_MAXLENGTH 200
#define THERMAL_PROTECTION_HOTENDS // Enable thermal protection for all extruders
#define THERMAL_PROTECTION_BED     // Enable thermal protection for the heated bed
#define THERMAL_PROTECTION_CHAMBER // Enable thermal protection for the heated chamber
#define USE_XMIN_PLUG
#define USE_ZMIN_PLUG
#define USE_YMAX_PLUG
#define ENDSTOPPULLUPS
#define X_MIN_ENDSTOP_INVERTING false // Set to true to invert the logic of the endstop.
#define Y_MIN_ENDSTOP_INVERTING false // Set to true to invert the logic of the endstop.
#define Z_MIN_ENDSTOP_INVERTING true  // Set to true to invert the logic of the endstop.
#define X_MAX_ENDSTOP_INVERTING false // Set to true to invert the logic of the endstop.
#define Y_MAX_ENDSTOP_INVERTING false // Set to true to invert the logic of the endstop.
#define Z_MAX_ENDSTOP_INVERTING false // Set to true to invert the logic of the endstop.
#define Z_MIN_PROBE_ENDSTOP_INVERTING true  // Set to true to invert the logic of the probe.
#define X_DRIVER_TYPE  TMC2209
#define Y_DRIVER_TYPE  TMC2209
#define Z_DRIVER_TYPE  TMC2209
#define E0_DRIVER_TYPE TMC2209
#define ENDSTOP_INTERRUPTS_FEATURE
#define DEFAULT_AXIS_STEPS_PER_UNIT   { 80, 80, 2020, 94.5 }
#define DEFAULT_MAX_FEEDRATE          { 500, 500, 7, 60 }
#define DEFAULT_MAX_ACCELERATION      { 2500, 2500, 150, 10000 }
#define LIMITED_MAX_ACCEL_EDITING     // Limit edit via M201 or LCD to DEFAULT_MAX_ACCELERATION * 2
  #define MAX_ACCEL_EDIT_VALUES       { 6000, 6000, 200, 20000 } // ...or, set your own edit limits
#define DEFAULT_ACCELERATION          700     // X, Y, Z and E acceleration for printing moves
#define DEFAULT_RETRACT_ACCELERATION  2000    // E acceleration for retracts
#define DEFAULT_TRAVEL_ACCELERATION   1500    // X, Y, Z acceleration for travel (non printing) moves
#define CLASSIC_JERK
  #define DEFAULT_XJERK 10
  #define DEFAULT_YJERK 10
  #define DEFAULT_ZJERK  0.3
  #define TRAVEL_EXTRA_XYJERK 2     // Additional jerk allowance for all travel moves
  #define LIMITED_JERK_EDITING        // Limit edit via M205 or LCD to DEFAULT_aJERK * 2
    #define MAX_JERK_EDIT_VALUES { 20, 20, 0.5, 10 } // ...or, set your own edit limits
#define DEFAULT_EJERK    4    // May be used by Linear Advance
#define S_CURVE_ACCELERATION
#define Z_MIN_PROBE_USES_Z_MIN_ENDSTOP_PIN
#define FIX_MOUNTED_PROBE
#define NOZZLE_TO_PROBE_OFFSET { 20, 0, 0 }
#define MIN_PROBE_EDGE 0
#define XY_PROBE_SPEED 9000
#define Z_PROBE_SPEED_FAST 300
#define Z_PROBE_SPEED_SLOW 120
#define MULTIPLE_PROBING 2
#define EXTRA_PROBING    1
#define Z_CLEARANCE_DEPLOY_PROBE   2  // Z Clearance for Deploy/Stow
#define Z_CLEARANCE_BETWEEN_PROBES  1 // Z Clearance between probe points
#define Z_CLEARANCE_MULTI_PROBE     1 // Z Clearance between multiple probes
#define Z_AFTER_PROBING           5   // Z position after probing is done
#define Z_PROBE_LOW_POINT          -2 // Farthest distance below the trigger-point to go before stopping
#define Z_PROBE_OFFSET_RANGE_MIN -7
#define Z_PROBE_OFFSET_RANGE_MAX 20
#define Z_MIN_PROBE_REPEATABILITY_TEST
#define X_ENABLE_ON 0
#define Y_ENABLE_ON 0
#define Z_ENABLE_ON 0
#define E_ENABLE_ON 0 // For all extruders
#define DISABLE_X false
#define DISABLE_Y false
#define DISABLE_Z false
#define DISABLE_E false             // For all extruders
#define INVERT_X_DIR true
#define INVERT_Y_DIR false
#define INVERT_Z_DIR false
#define INVERT_E0_DIR false
#define INVERT_E1_DIR false
#define INVERT_E2_DIR false
#define INVERT_E3_DIR false
#define INVERT_E4_DIR false
#define INVERT_E5_DIR false
#define INVERT_E6_DIR false
#define INVERT_E7_DIR false
#define Z_HOMING_HEIGHT  3        // (mm) Minimal Z height before homing (G28) for Z clearance above the bed, clamps, ...
#define X_HOME_DIR -1
#define Y_HOME_DIR 1
#define Z_HOME_DIR -1
#define X_BED_SIZE 152
#define Y_BED_SIZE 152
#define X_MIN_POS 0
#define Y_MIN_POS 0
#define Z_MIN_POS 0
#define X_MAX_POS X_BED_SIZE
#define Y_MAX_POS Y_BED_SIZE
#define Z_MAX_POS 152
#define MIN_SOFTWARE_ENDSTOPS
  #define MIN_SOFTWARE_ENDSTOP_X
  #define MIN_SOFTWARE_ENDSTOP_Y
  #define MIN_SOFTWARE_ENDSTOP_Z
#define MAX_SOFTWARE_ENDSTOPS
  #define MAX_SOFTWARE_ENDSTOP_X
  #define MAX_SOFTWARE_ENDSTOP_Y
  #define MAX_SOFTWARE_ENDSTOP_Z
#define AUTO_BED_LEVELING_BILINEAR
#define RESTORE_LEVELING_AFTER_G28
  #define ENABLE_LEVELING_FADE_HEIGHT
  #define SEGMENT_LEVELED_MOVES
  #define LEVELED_SEGMENT_LENGTH 5.0 // (mm) Length of all segments (except the last one)
  #define G26_MESH_VALIDATION
    #define MESH_TEST_NOZZLE_SIZE    0.4  // (mm) Diameter of primary nozzle.
    #define MESH_TEST_LAYER_HEIGHT   0.2  // (mm) Default layer height for the G26 Mesh Validation Tool.
    #define MESH_TEST_HOTEND_TEMP  205    // (°C) Default nozzle temperature for the G26 Mesh Validation Tool.
    #define MESH_TEST_BED_TEMP      60    // (°C) Default bed temperature for the G26 Mesh Validation Tool.
    #define G26_XY_FEEDRATE         20    // (mm/s) Feedrate for XY Moves for the G26 Mesh Validation Tool.
    #define G26_RETRACT_MULTIPLIER   1.0  // G26 Q (retraction) used by default between mesh test elements.
  #define GRID_MAX_POINTS_X 3
  #define GRID_MAX_POINTS_Y GRID_MAX_POINTS_X
    #define EXTRAPOLATE_BEYOND_GRID
    #define ABL_BILINEAR_SUBDIVISION
      #define BILINEAR_SUBDIVISIONS 3
#define Z_SAFE_HOMING
  #define Z_SAFE_HOMING_X_POINT ((X_BED_SIZE) / 2)    // X point for Z homing when homing all axes (G28).
  #define Z_SAFE_HOMING_Y_POINT ((Y_BED_SIZE) / 2)    // Y point for Z homing when homing all axes (G28).
#define HOMING_FEEDRATE_XY (50*60)
#define HOMING_FEEDRATE_Z  (4*60)
#define VALIDATE_HOMING_ENDSTOPS
#define EEPROM_SETTINGS       // Persistent storage with M500 and M501
#define EEPROM_CHITCHAT       // Give feedback on EEPROM commands. Disable to save PROGMEM.
#define EEPROM_BOOT_SILENT  // Keep M503 quiet and only give errors during first load
  #define EEPROM_AUTO_INIT    // Init EEPROM automatically on any errors.
#define DEFAULT_KEEPALIVE_INTERVAL 2  // Number of seconds between "busy" messages. Set with M113.
#define BUSY_WHILE_HEATING            // Some hosts require "busy" messages even during heating
#define PREHEAT_1_LABEL       "PLA"
#define PREHEAT_1_TEMP_HOTEND 200
#define PREHEAT_1_TEMP_BED     60
#define PREHEAT_1_FAN_SPEED     30 // Value from 0 to 255
#define PREHEAT_2_LABEL       "ABS"
#define PREHEAT_2_TEMP_HOTEND 230
#define PREHEAT_2_TEMP_BED    90
#define PREHEAT_2_FAN_SPEED     0 // Value from 0 to 255
#define NOZZLE_PARK_FEATURE
  #define NOZZLE_PARK_POINT { (X_MIN_POS + 10), (Y_MAX_POS - 10), 10 }
  #define NOZZLE_PARK_XY_FEEDRATE 100   // (mm/s) X and Y axes feedrate (also used for delta Z axis)
  #define NOZZLE_PARK_Z_FEEDRATE 5      // (mm/s) Z axis feedrate (not used for delta printers)
#define PRINTJOB_TIMER_AUTOSTART
#define PRINTCOUNTER
#define LCD_LANGUAGE en
#define DISPLAY_CHARSET_HD44780 WESTERN
#define LCD_INFO_SCREEN_STYLE 0
#define SDSUPPORT
#define SD_CHECK_AND_RETRY
#define INDIVIDUAL_AXIS_HOMING_MENU
#define CR10_STOCKDISPLAY
#define FAN_SOFT_PWM
#define SOFT_PWM_SCALE 0
#define SERVO_DELAY { 300 }
