Printrbot/Adaptrboard/Simple Pro/Simple Pro - Fyssetc Cheetah 1.1b/FlyMcuConfig.ini

[Comm]
Port=0
PortBps=4
[FileSetting]
chkbReloadFile=1
FileName=C:\Users\Philip Mally\Documents\Marlin-Gui\2.0.5.3\Marlin\.pio\build\STM32F103RC_fysetc\firmware.hex
PageControl1Index=1
N2Checked=1
language=1
[LPCSetting]
LastSuccessBps=9600
OscFreq=20000
rgLpcEraseAllBlock=1
rgLpc1FC=0
cbISPEN_WDT=0
[STMSetting]
cbSTMExecAfterFlash=1
cbVerify=1
cbRtsDtrUsage->ItemIndex=6
MenuUseEagleComm=0
menuBeepEnable=0
menuEnableHighBps=0
menuUseRamIsp=0
cbAutoProgram=0
cbSTMWriteOption=1
STMOptionBytes=A5FFFFFFFFFFFFFF
STM32F2_F4OptionBytes=AAFFFFF
[FormWindow]
WindowState=0
WindowXDPI=96
WindowYDPI=96
WindowClientHeight96=499
WindowClientWidth96=1014
WindowLeft96=-1136
WindowTop96=272
[fmSerialNoSetting]
cbUseID=0
medAddress=0x08000000
medLength=16
medInit=4
medIncLen=1
rgEndian=0
rgSnInFlashOrEeprom=0
cbSerialNoFormat=0
[fmSerialization]
cbEnableSerialization=0
edMcuIspDllFileName=
[fmProgCount]
medProgCount=0
[fmMSP430Settings]
orgVecs=FFFFFFFFFFFFFFFFFFFFFFFFFFFFFFFFFFFFFFFFFFFFFFFFFFFFFFFFFFFFFFFF
Vecs=FFFFFFFFFFFFFFFFFFFFFFFFFFFFFFFFFFFFFFFFFFFFFFFFFFFFFFFFFFFFFFFFFFFFFFFFFFFFFFFFFFFFFFFFFFFFFFFFFFFFFFFFFFFFFFFFFFFFFFFFFFFFFFFF
BSLKeys=FFFFFFFFFFFFFFFFFFFFFFFFFFFFFFFFFFFFFFFFFFFFFFFFFFFFFFFFFFFFFFFFFFFFFFFFFFFFFFFFFFFFFFFFFFFFFFFFFFFFFFFFFFFFFFFFFFFFFFFFFFFFFFFFFFFFFFFFFFFFFFFFFFFFFFFFFFFFFFFFFFFFFFFFFFFFFFFFFFFFFFFFFFFFFFFF
PortSettings=1
MiscSettings=0
cbEnableAdvanceVectorModify=0
