Printrbot/Adaptrboard/(commit log)

2019-12-13 marlin 2 source and firmware
    initial firmare
    [Configuration.h, Configuration_adv.h]
2019-12-13 serial ports fixed
    serial ports and tmc2130 communication issue fixed
    [Configuration.h, Configuration_adv.h]
2020-01-02 added play firmware
    [Configuration.h, Configuration_adv.h]
2020-01-15 added changes and updates
    config for dual extrusion on skr 1.3
    [Configuration.h, Configuration_adv.h]
2020-01-20 play e3 firmware
    [Configuration.h, Configuration_adv.h]
2020-04-18 add new configs and firmware.bin
    [Configuration.h, Configuration_adv.h]
2020-04-26 new firmware for SKR LCD
    [Configuration.h, Configuration_adv.h]
2020-04-26 STL Files for Beds
    [Adoptabot X Axis Bed.stl, Play Heated Bed Model 100mmx205mm.stl, Printrbot Plus Bed - Alu Only.stl, Printrbot Smalls Bed.stl, Simple Metal 10in bed.stl, Simple Metal 10x8in bed.stl, Simple Metal Stock Bed.stl, Simple Pro Print Bed.stl]
2020-04-26 Update Adoptabot X Axis Bed.stl
    [Adoptabot X Axis Bed.stl]
2020-04-26 updates to firmware configs
    [Configuration.h, Configuration_adv.h]
2020-04-26 custom printrbot icons
2020-04-28 updated firmware
    [Configuration.h, Configuration_adv.h]
2020-04-28 updates to latest config
    [Configuration.h, Configuration_adv.h]
2020-04-28 small changes to file names
    [Configuration.h, Configuration_adv.h]
2020-04-28 STL files for enclosures
    [Adaptrboard Case.stl, Motor Breakout Case.stl, Thermistor Case.stl]
2020-04-28 Create Simple Metal SKR Mount.stl
    [Simple Metal SKR Mount.stl]
2020-05-09 config updates
    [Configuration.h, Configuration_adv.h]
2020-05-11 updated desgin for stl skr board mount
    [Adaptrboard Case.stl, Metal Plus Adaptrboard_Board Mount v1.stl, Metal Plus Adaptrboard_Stepper Fan Duct 40mmv1.stl, Motor Breakout Case.stl, Simple Metal - Adaptrboard - Control Board Mont.stl, Simple Metal - Adaptrboard - Controler Fan Duct.stl, Simple Metal - Front and Rear Feet.stl, Simple Metal SKR Mount.stl]
2020-05-12 added common replacement parts
    [50 Fan Mount.stl, 50mm Fan Mount.stl, Delrin Cable tab from back of extruder.dxf, Fan Blower v2 Left.stl, Fan Blower v2 Right.stl, Fan Mount.stl, Inductive Probe Clamp.stl, MP Sensor Mount v1.stl]
2020-05-15 Create Simple Metal - Adaptrboard - Control Board Mont - Plastite Screws.stl
    [Simple Metal - Adaptrboard - Control Board Mont - M3 Nut.stl, Simple Metal - Adaptrboard - Control Board Mont - Plastite Screws.stl]
2020-05-17 Create Playv2-SimplePro-Fan Shroud v4.stl
    [Playv2-SimplePro-Fan Shroud v4.stl]
2020-05-17 Update Playv2-SimplePro-Fan Shroud v4.stl
    [Playv2-SimplePro-Fan Shroud v4.stl]
2020-05-18 lifts the printer off the table
    [Metal Plus Foot L.stl, Metal Plus Foot R.stl]
2020-05-20 optimized firmware
    SKR 1.4 Turbo - NPN - Motion Optimized for 32bit
    [Configuration.h, Configuration_adv.h]
2020-05-20 metal plus firmware
    G34 Auto Allign needs to be tested. Motor direction needs testing.
    [Configuration.h, Configuration_adv.h]
2020-05-23 lcd firmware update and fix for stepper fan duct for metal plus
    [Metal Plus Adaptrboard_Stepper Fan Duct 40mmv1.stl]
2020-05-24 Create Playv2-SimplePro-Fan Shroud v4 v3.stl
    [Playv2-SimplePro-Fan Shroud v4 v3.stl]
2020-05-25 bug fixes and updates
    [Configuration.h, Configuration_adv.h, LRS-350 PSU Case v3.step, LRS-350-12 Case.stl]
2020-05-28 Simple Metal firmware
    [Configuration.h, Configuration_adv.h]
2020-05-28 bug fixes
    [Configuration.h, Configuration_adv.h]
