Printrbot/Adaptrboard/(notices)

Notices in the files:
Play/SKR Mini e3 v1.2/Latest Build/Configuration_adv.h:
Copyright (c) 2020 MarlinFirmware [https://github.com/MarlinFirmware/Marlin]
Copyright (c) 2011 Camiel Gubbels / Erik van der Zalm
This program is free software: you can redistribute it and/or modify
it under the terms of the GNU General Public License as published by
the Free Software Foundation, either version 3 of the License, or
(at your option) any later version.
define TOUCH_UI_UTF8_COPYRIGHT // © ®
